Wuhy0411/-/README.md

# 🐁 小鼠滚轮实验平台 (Mouse Running Wheel System)





## 📌 项目简介

本项目旨在通过整合底层硬件外设与上位机软件，搭建一套完整、稳定的小鼠滚轮行为学实验平台。该平台能够实时监测、记录并可视化小鼠在滚轮上的运动速度和路程。

采集到的高精度时间序列数据（如速度、运动距离以及外部输入的ttl信息），格式规整，可直接导出参与后续分析。

---

## 🛠️ 系统架构与环境依赖

本项目由**硬件数据采集端（下位机）** 与**软件数据处理端（上位机）** 两部分组成。

### 1. 硬件环境 (Hardware)
* **核心控制板：** ArControl开发板
* **传感器：** 旋转编码器
* **机械组件：** 标准小鼠测试滚轮、3D打印固定支架等
* **通信线路：** USB 数据传输线

具体的硬件清单在硬件文件夹里的硬件清单.xlsx文件里，根据对应的数量和链接购买拼装即可。

### 2. 软件环境 (Software)
详细的环境安装与配置步骤，请参阅 [《软件开发环境安装指南》](软件/软件安装流程.md)。
* **下位机开发环境：** Arduino IDE
* **上位机开发环境：** VS Code
* **上位机语言与依赖：**
  * Python 3.14 及以上版本
  * `pyserial`：用于与 Arduino 进行串口数据通信
  * `matplotlib`：用于运动数据的实时动态可视化

---

## 🚀 快速开始 (操作说明)

### 第一步：硬件连接
按照硬件拼接教程组装好跑台，具体操作步骤请参阅[《硬件安装步骤说明》](硬件/硬件拼装流程.md)。

### 第二步：下位机程序烧录 (Arduino端)
1. 将Arduino与电脑连接

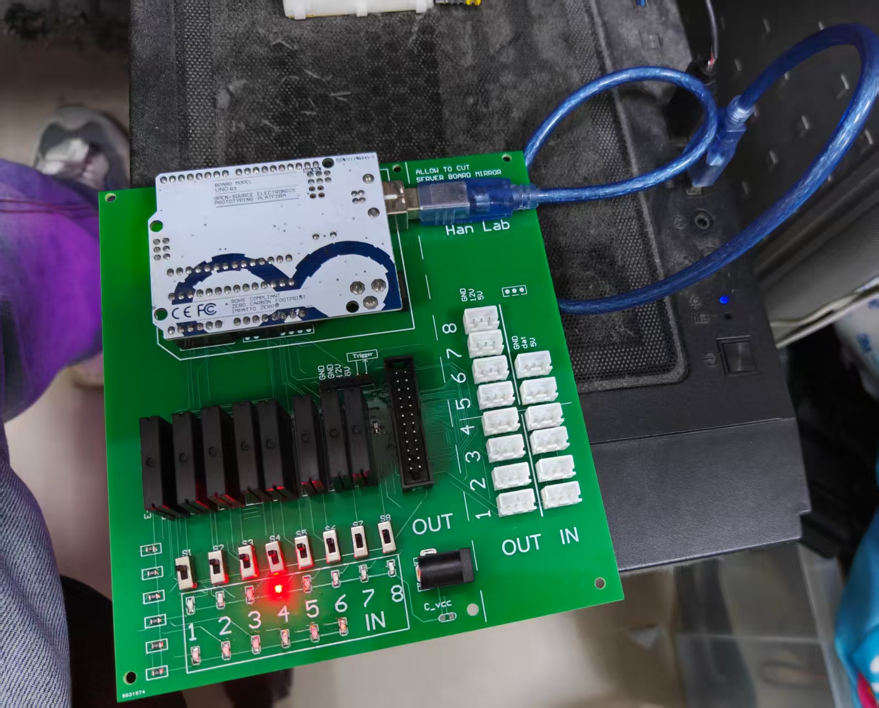
[picture p1: images/1.jpg]
   

2. 打开 `Arduino IDE`。

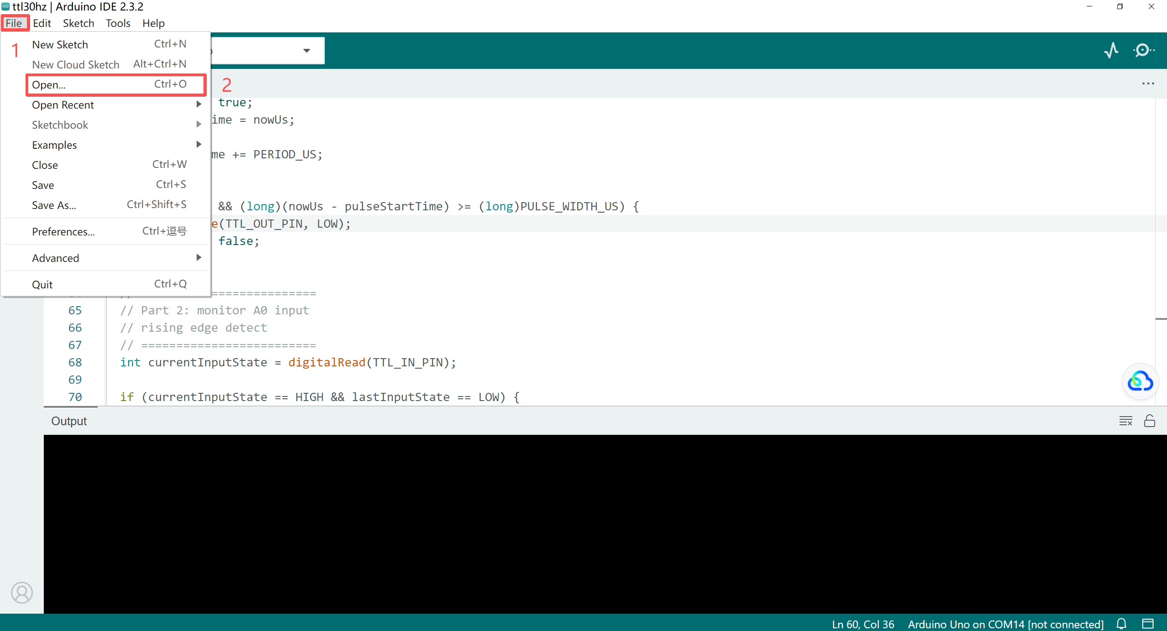
[picture p2: images/2.png]
   

3. 导入本项目 `软件/代码` 目录下的 `TTL monitoring.ino` 源码文件。

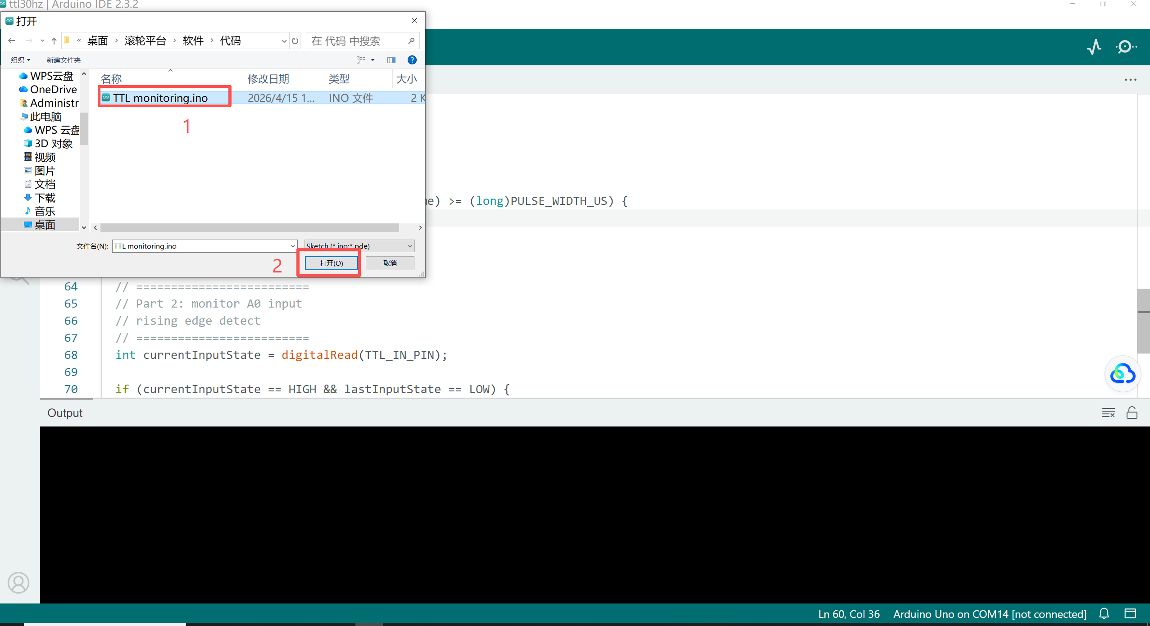
[picture p3: images/3.png]
   

4. 在菜单栏选择对应的开发板型号（arduino uno）及正确识别的 COM 端口（如这里的COM15）。

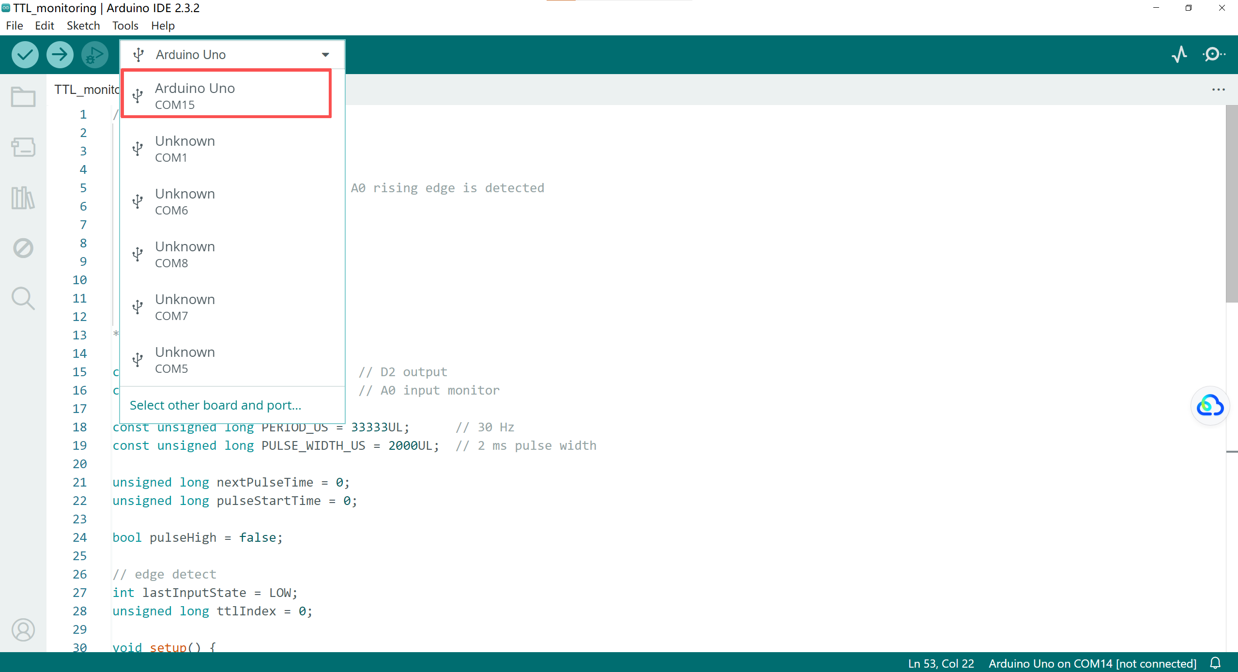
[picture p4: images/4.png]
   

5. 依次点击 **编译**  、**上传 (Upload)** 按钮，将代码烧录至控制板。

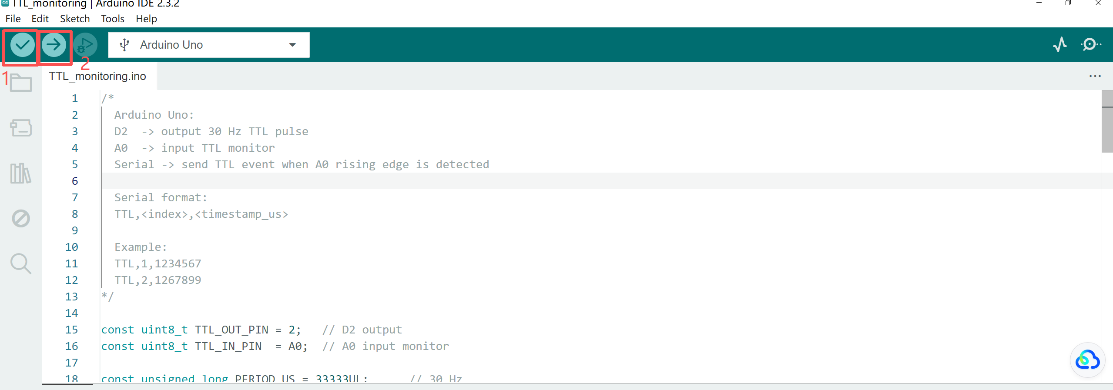
[picture p5: images/5.png]
   

6. 观察到板子上的1口有红灯快速的闪烁即代表烧录成功

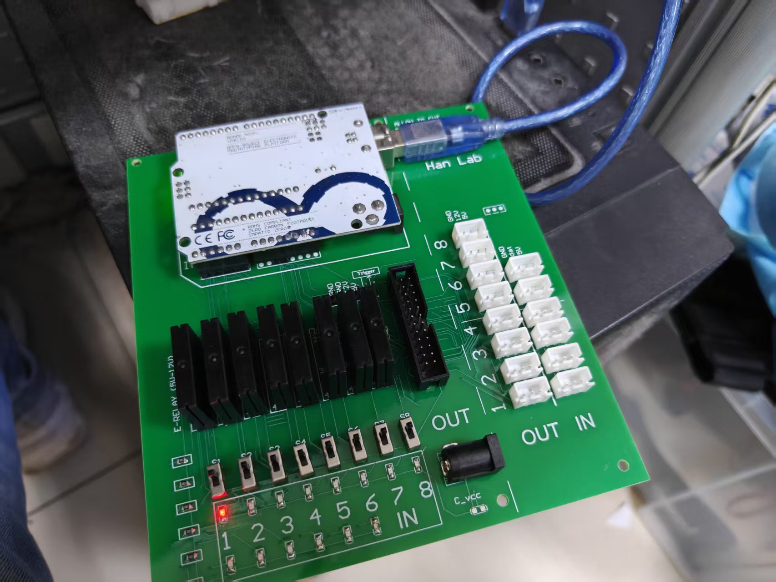
[picture p6: images/6.jpg]
   

### 第三步：上位机数据采集与可视化 (Python端)
1. 右键`软件/代码` 目录下的 `GUI.py` 源码文件，点击打开方式，选择用VS Code打开。

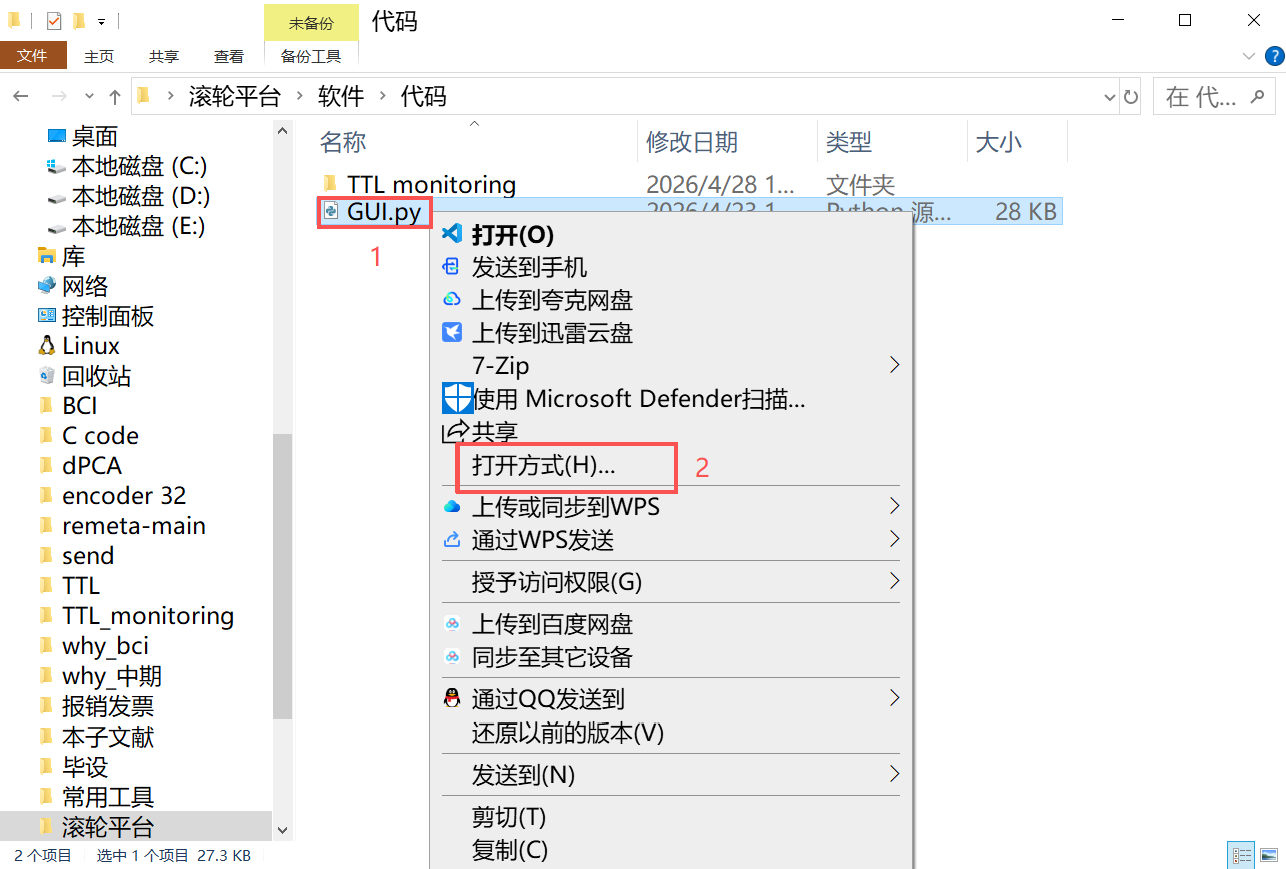
[picture p7: images/7.png]
   

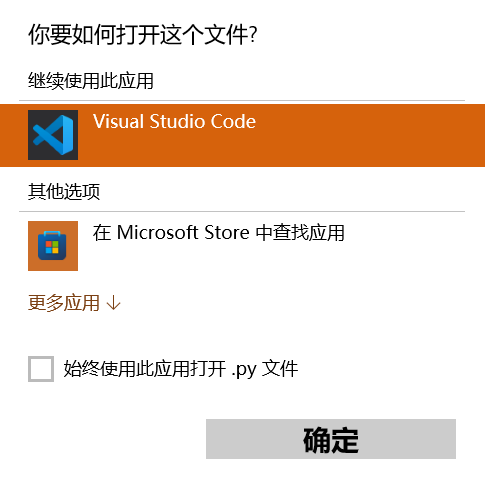
[picture p8: images/8.png]
   

2. 连接好旋转编码器

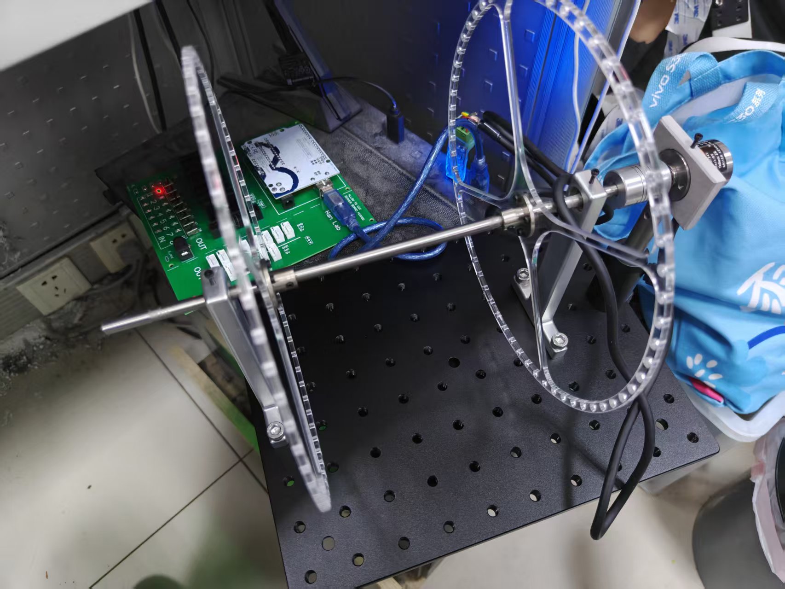
[picture p9: images/9.jpg]
   

3. 检查串口号配置：打开设备管理器，查看端口的下拉菜单，查询到Arduino板子和编码器的端口号分别为`COM15` 和`COM13`，记住这两个端口号。

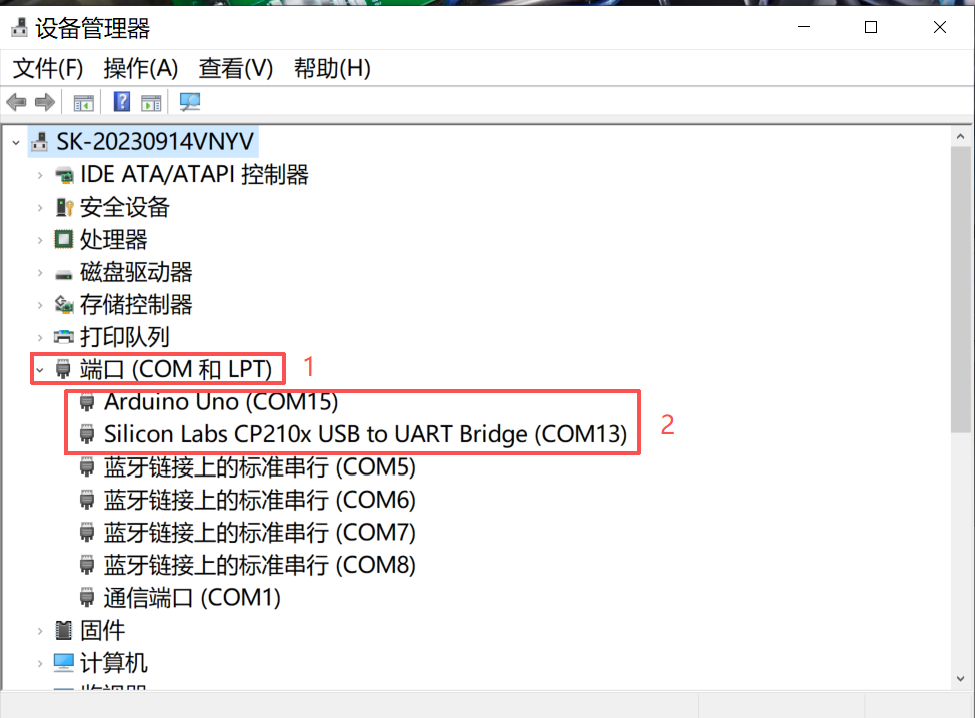
[picture p10: images/10.png]
   

4. 找到GUI主程序的对应位置进行修改。

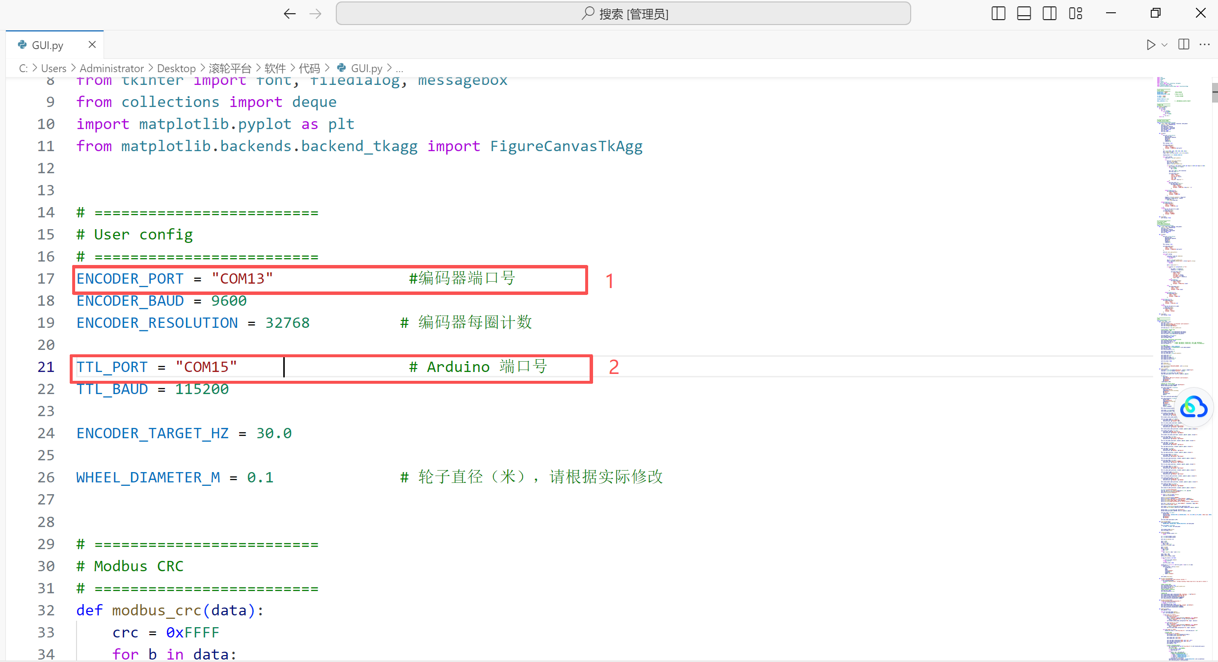
[picture p11: images/11.png]
   

5. 运行主程序开始实验。

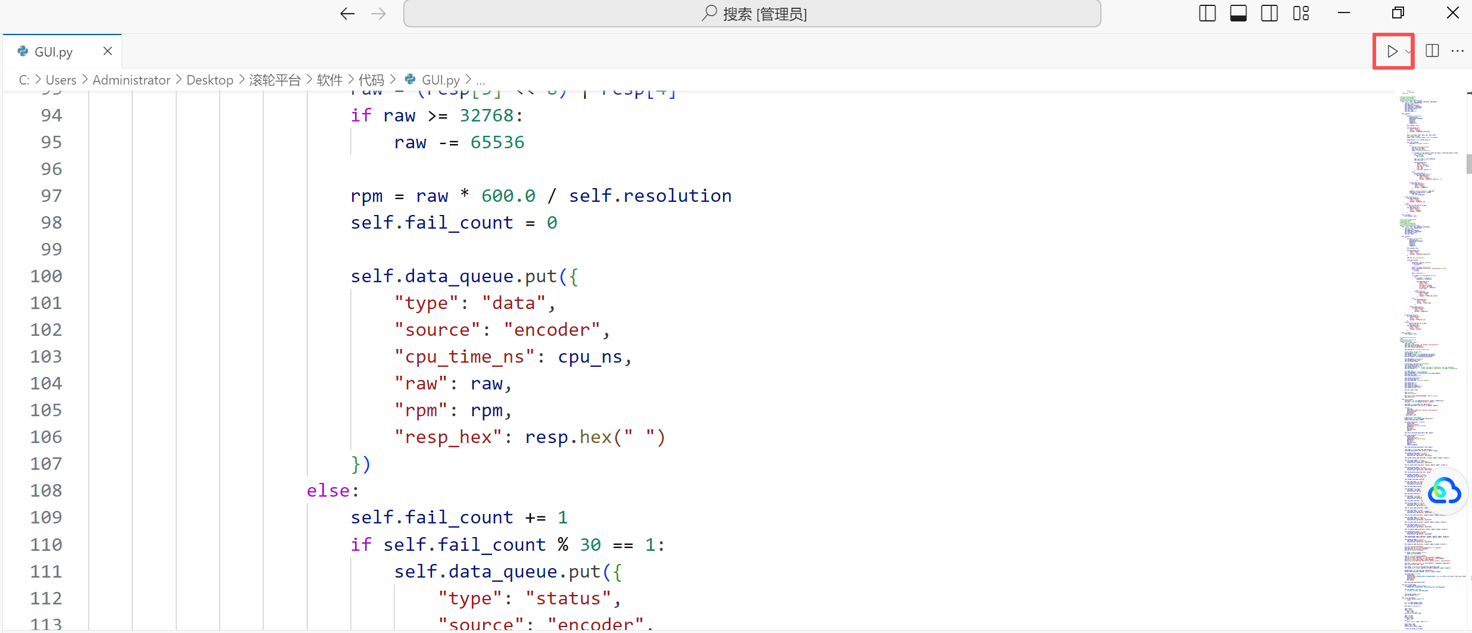
[picture p12: images/12.png]
   

6. **运行现象：**

   * 终端将实时打印旋转编码器的转速和ttl信号数据。

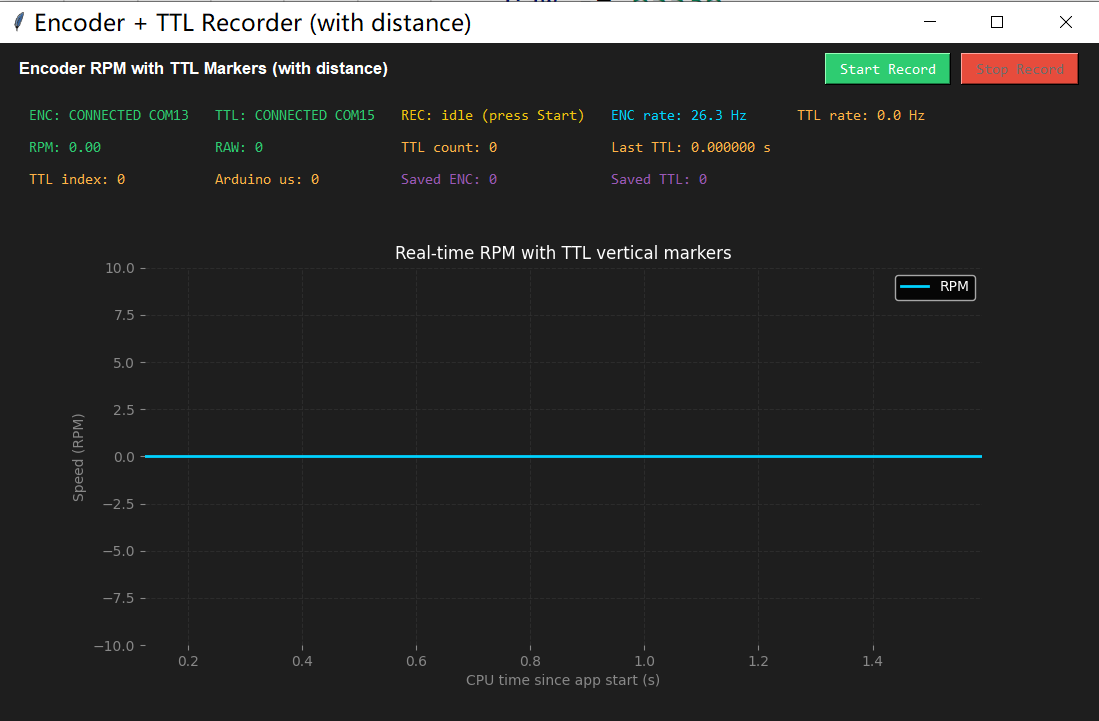
[picture p13: images/13.png]
     

   * 点击start record按钮开始记录转速信息，点击end record结束记录。

   * 点击右上角关闭按钮，弹出保存的csv文件，点击`是` ，找到合适位置点击保存。

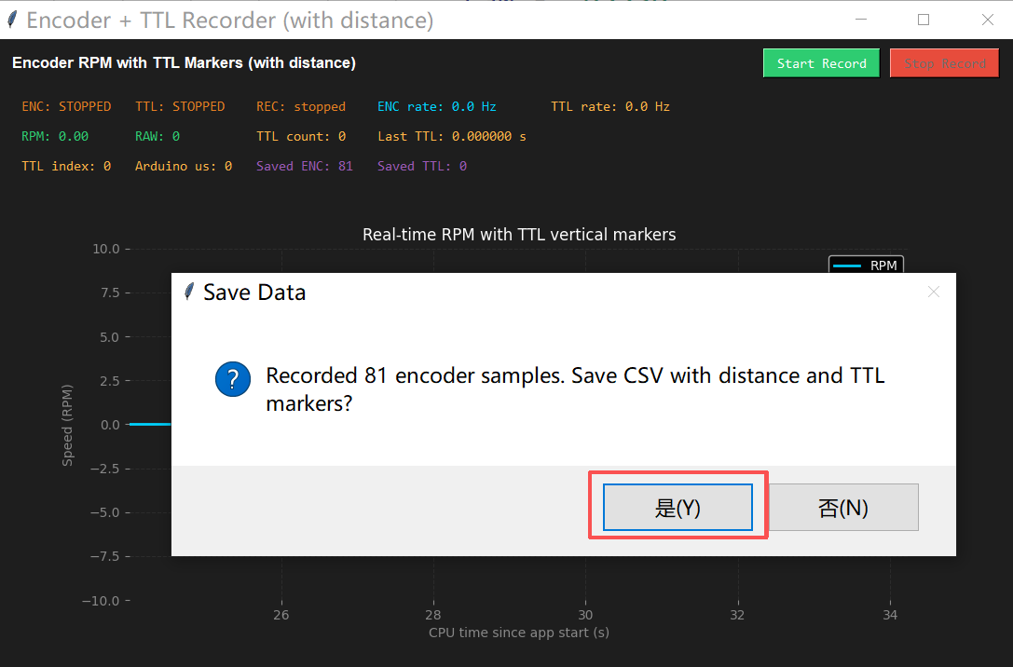
[picture p14: images/14.png]
     

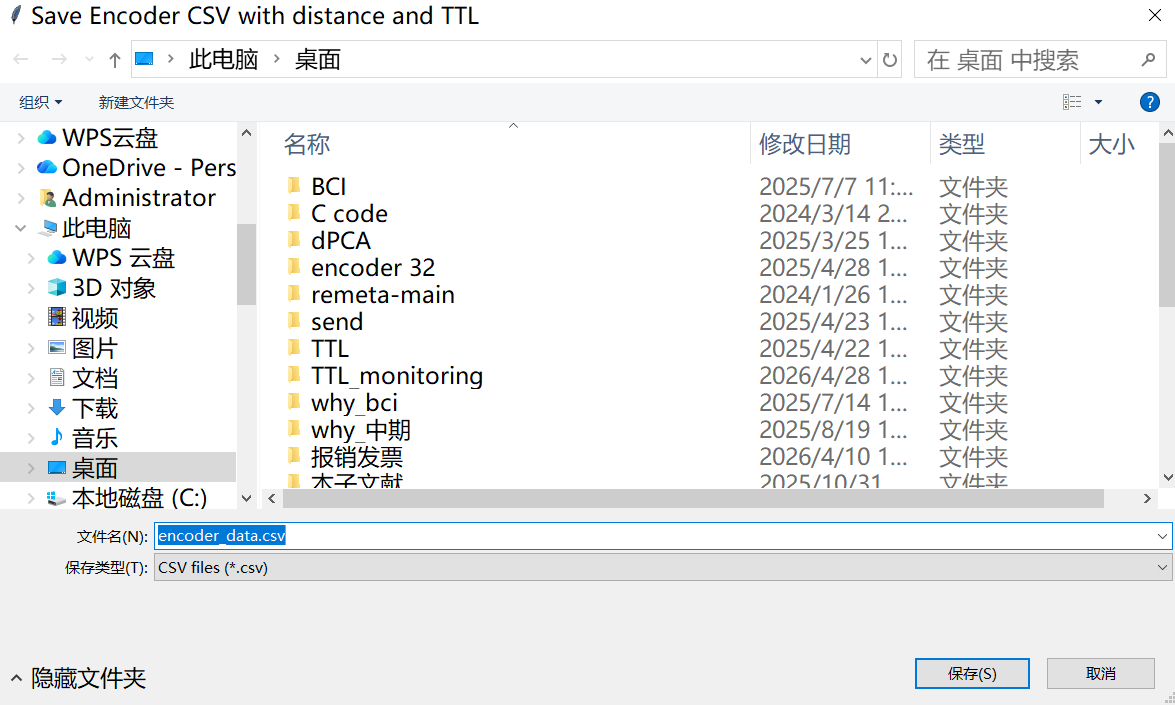
[picture p15: images/15.png]
     

---

## 📁 数据输出说明

实验结束后，关闭GUI界面，会弹出一个保存csv文件的界面，选择对应的文件夹点击保存即可。

**数据包含以下核心字段：**

* `record_rel_s`: 相对记录时间（从点击“Start Record”到该编码器样本的时间间隔，单位秒）
* `cpu_time_ns`: 绝对 CPU 时间戳（纳秒，用于精确对齐）
* `raw`: 编码器原始读数（16位有符号整数，范围 -32768 ~ 32767，对应每圈 32768 个计数）
* `rpm`: 瞬时转速（转/分钟，计算公式：`raw × 600.0 / 32768`）
* `distance_m`: 累计路程（米，根据 `raw` 变化量乘以轮子周长累加得到）
* `ttl_event`: TTL 事件标记（布尔值 0 或 1，1 表示该编码器样本在时间上最接近某个 TTL 脉冲）
* `ttl_index`: TTL 脉冲序号（当 `ttl_event = 1` 时记录对应的序号，来自 Arduino 串口；否则为空）

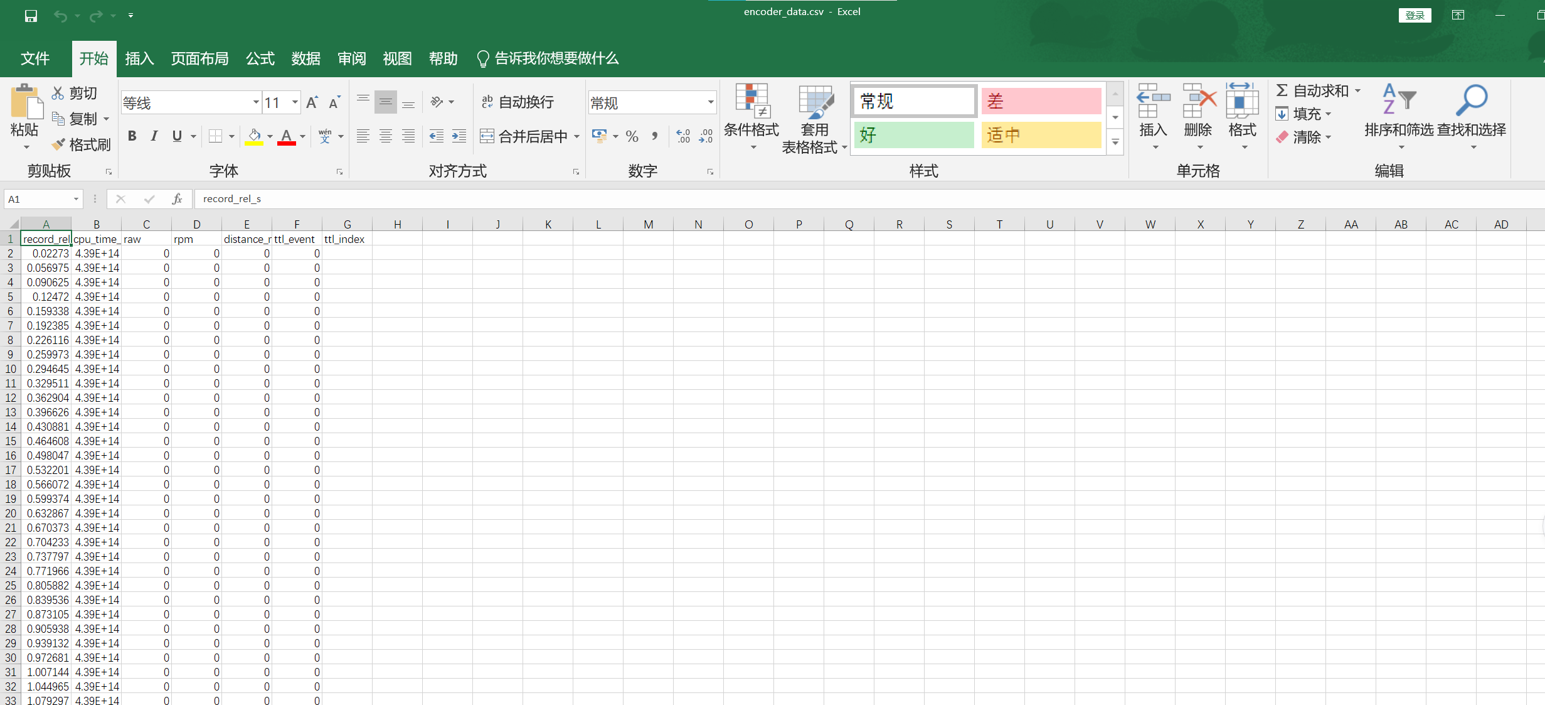
[picture p16: images/16.png]


---

## 🤝 贡献与维护
如有硬件连接问题或软件 Bug，请在项目中提交 Issue 或联系平台维护人员。
