Wuhy0411/-/硬件/3D打印/3D打印流程.md

# 🖨️ 编码器固定器 3D 打印流程指南

本文档将指导您在“未来工厂”平台完成编码器固定器的 3D 打印下单流程，涵盖模型上传、材料选择、特殊工艺（攻牙）配置及最终的订单提交。

---

## 📦 下单操作步骤

### 1. 登录平台与上传模型
1. 在浏览器中打开 **未来工厂** 官方下单网站：<https://www.wenext.cn/manufacture/>
2. 点击页面区域内的 **上传文件**，在弹出的窗口中找到并选择您的模型文件（ `编码器固定器.STL`），等待系统上传并解析完成。
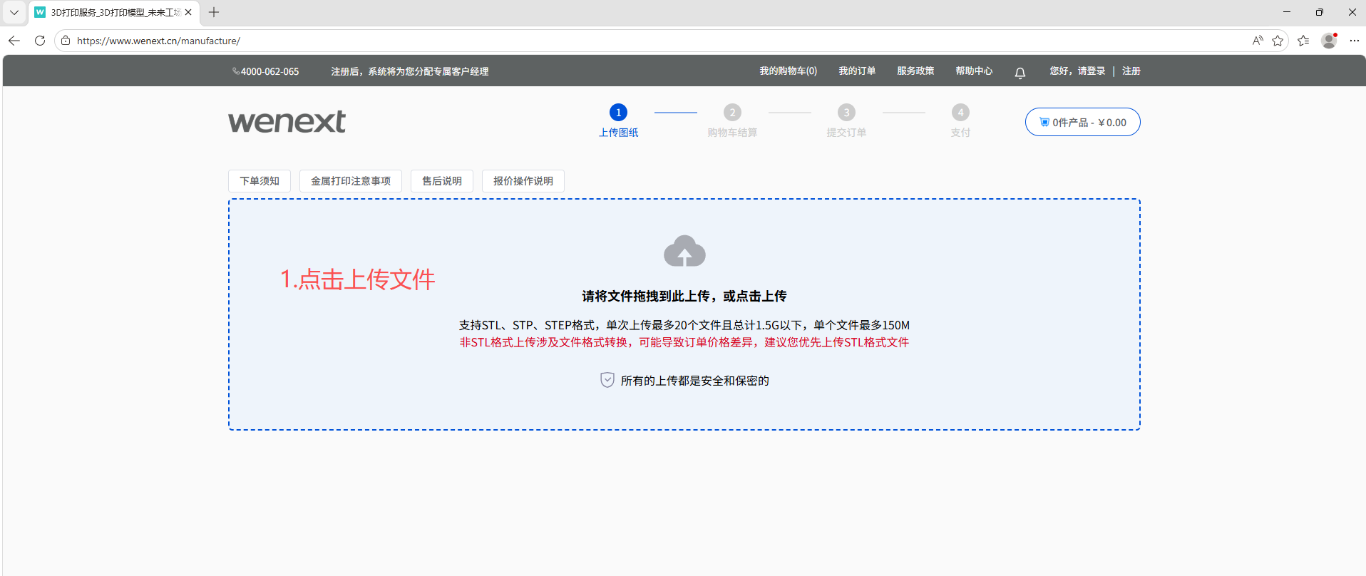
[picture p60: 硬件/3D打印/images/图片1.png]
   
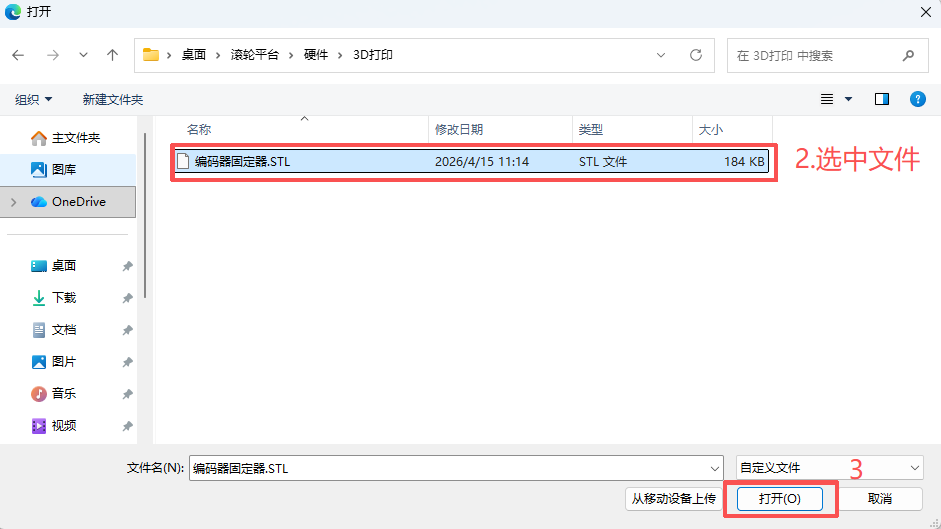
[picture p61: 硬件/3D打印/images/图片2.png]
   

### 2. 选择打印材料
1. 模型解析完毕后，进入参数配置界面。
2. 在材料列表中找到金属类别，将打印材料指定为 **铝合金 6061**。
   > 💡 **提示**：铝合金 6061 具备良好的强度和加工性，非常适合作为滚轮平台硬件的固定连接件。
   
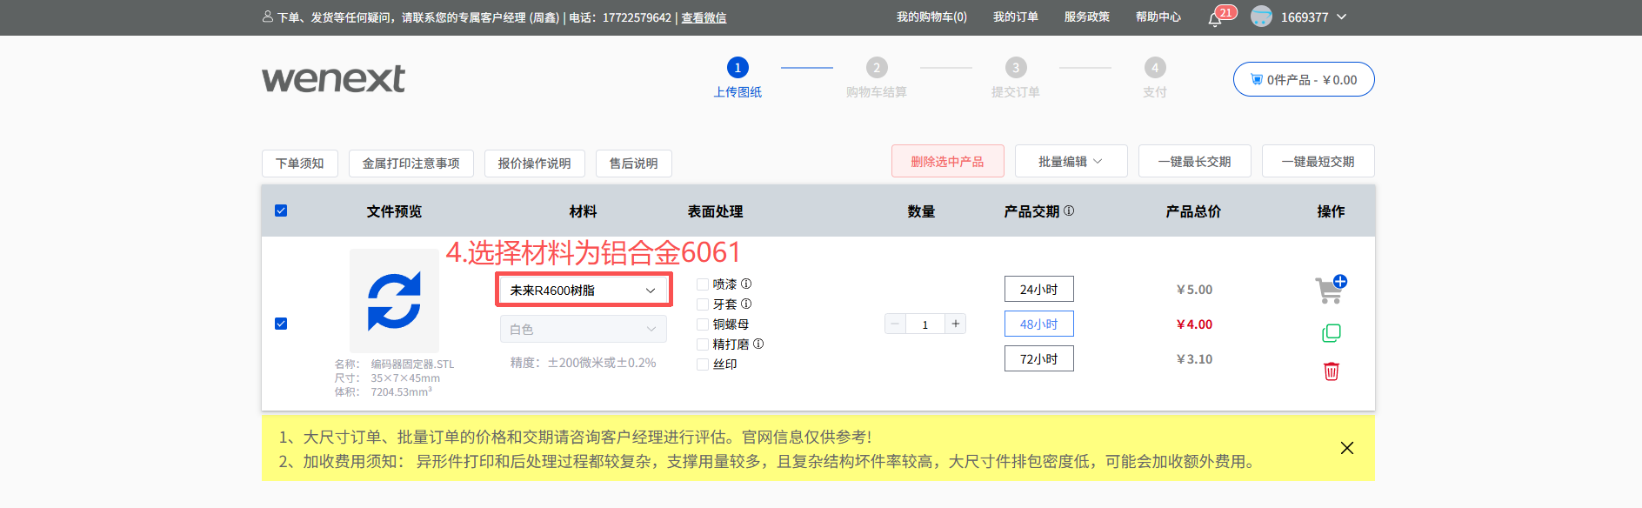
[picture p62: 硬件/3D打印/images/图片3.png]
   
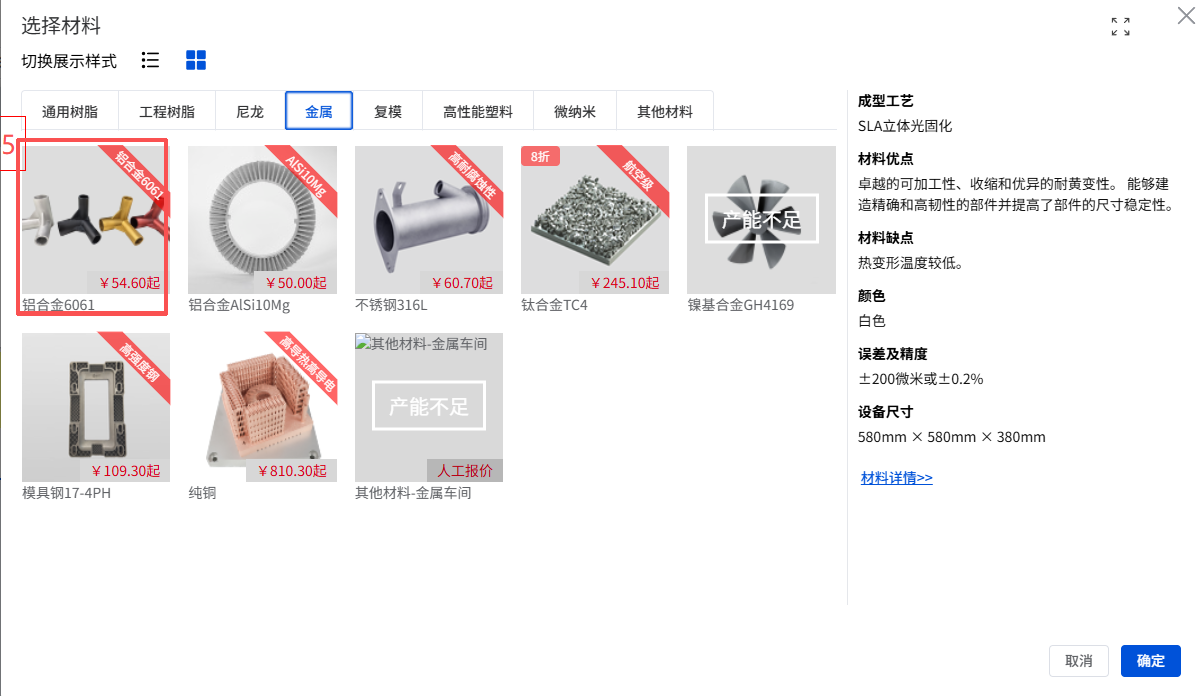
[picture p63: 硬件/3D打印/images/图片4.png]
   

### 3. 配置加工参数（数量与攻牙）
1. 确认该部件的打印 **数量** 设置为 **1**。
2. 在附加服务或表面处理区域，找到并勾选 **攻牙** 服务。
3. 根据项目设计需求，在弹出的规格表中准确填写攻牙类型，包含 **M2** 和 **M4** 规格。
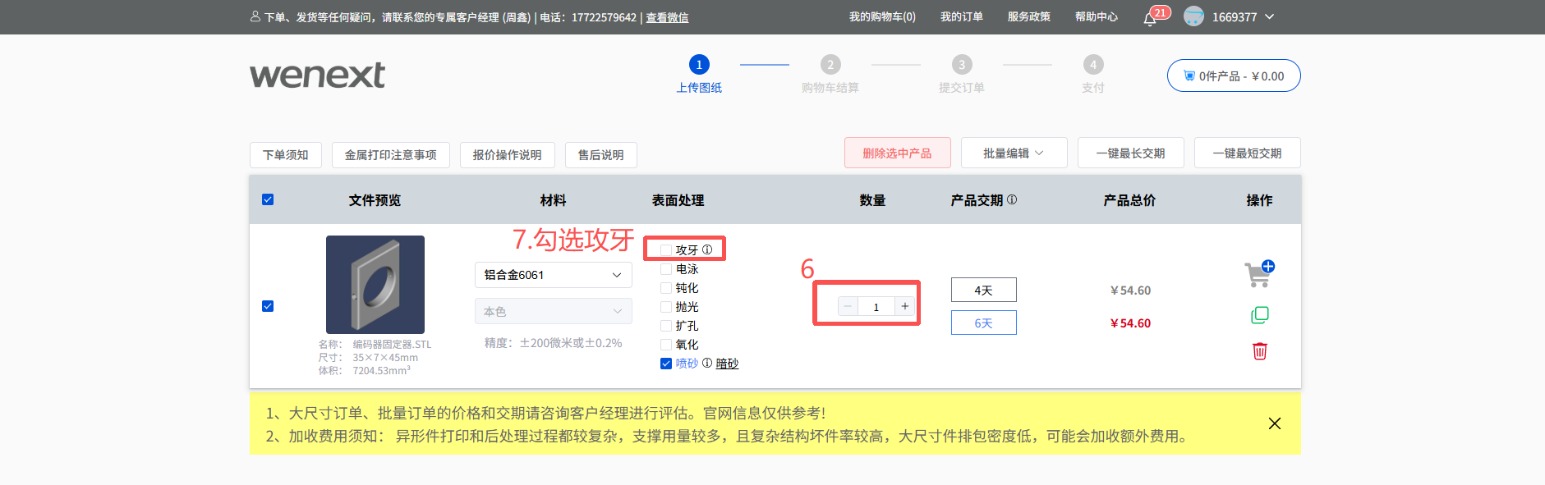
[picture p64: 硬件/3D打印/images/图片5.png]
   
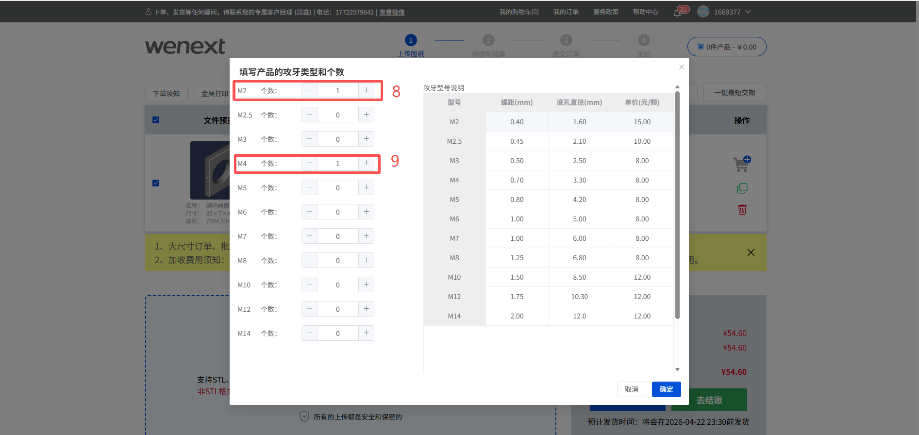
[picture p65: 硬件/3D打印/images/图片6.png]
   

### 4. 结算进入订单页
1. 确认模型预览、材料、数量和攻牙服务均配置无误后，点击页面右下角的 **去结账** 按钮，进入订单结算页面。
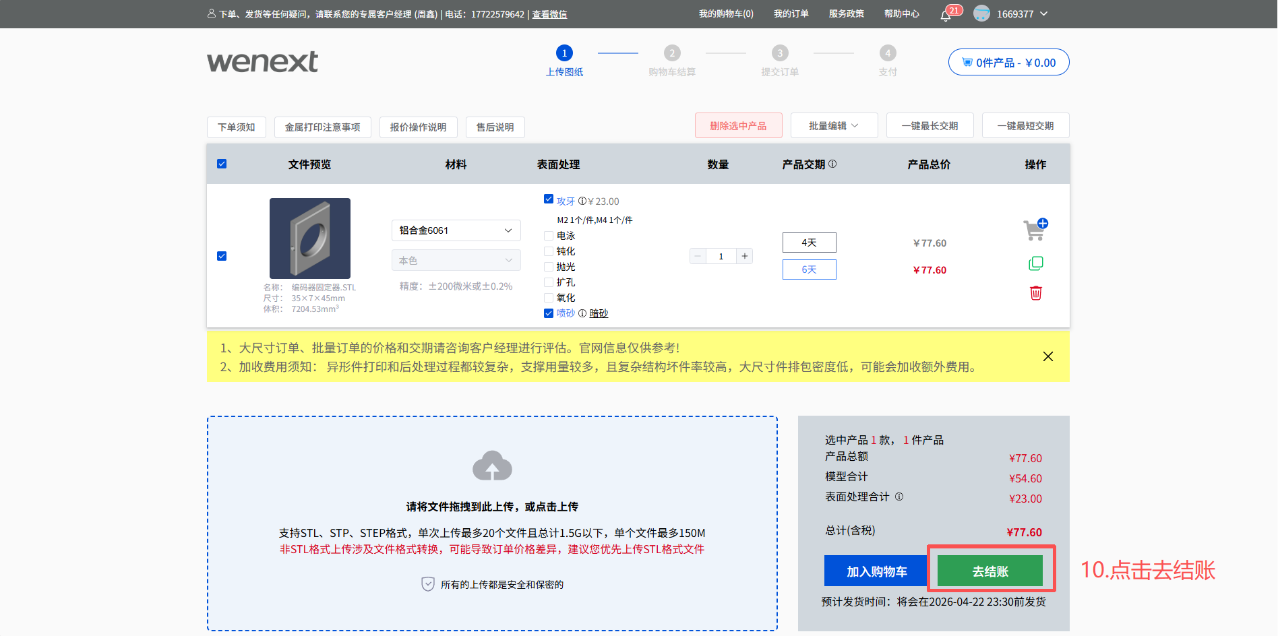
[picture p66: 硬件/3D打印/images/图片7.png]
   

### 5. 填写收货信息与上传附件
1. 在订单确认页面，仔细填写或核对您的 **收货人信息**（姓名、联系方式、收货地址）。
2. **非常重要**：在页面下方找到“处理附件”或“上传攻牙附件”的选项，点击并上传对应的加工说明文档（ `3D打印附件.docx`）。
   
   > ⚠️ **注意**：攻牙附件图纸是工厂确认螺纹孔具体位置的唯一凭证，遗漏上传可能会导致加工错误或订单被驳回。
   
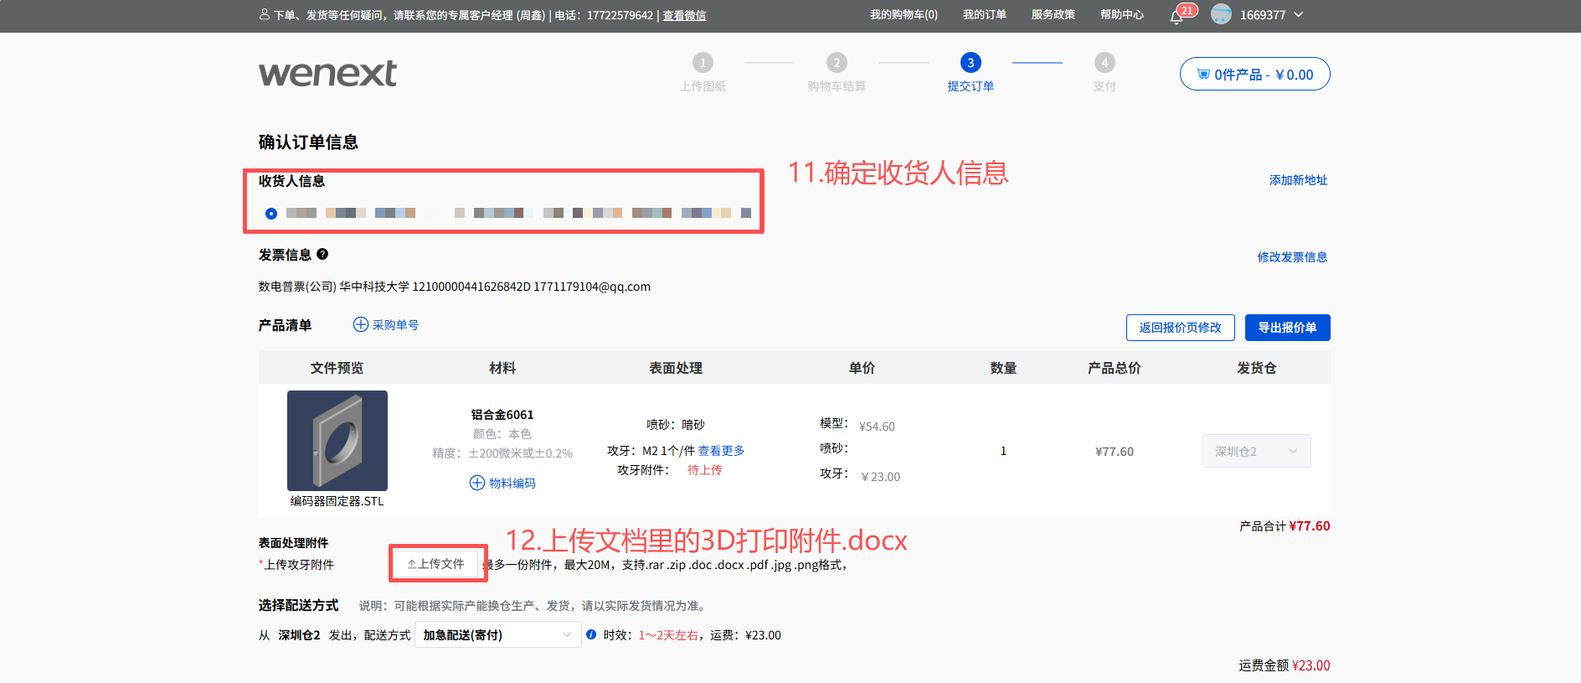
[picture p67: 硬件/3D打印/images/图片8.png]
   
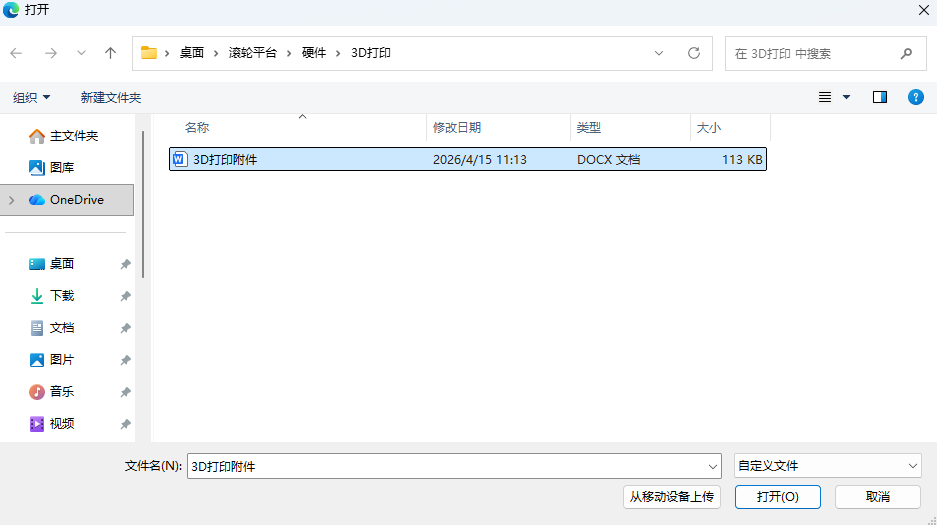
[picture p68: 硬件/3D打印/images/图片9.png]
   

### 6. 提交订单
最后核对产品的总价、交期以及发票等信息，确认无误后点击 **提交订单**，随后根据页面提示完成支付即可安排生产。
