Wuhy0411/-/硬件/3D打印/3D打印附件.docx

攻牙位置：长边顶部和底部中心

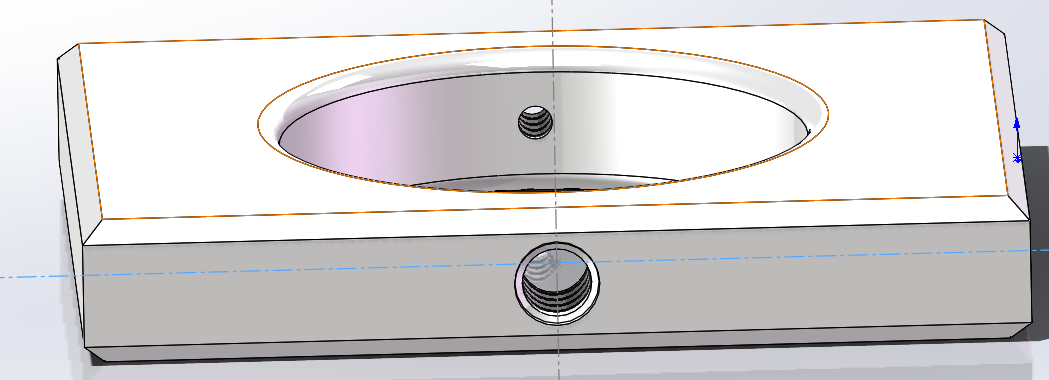
[picture p69: figure]
