Wuhy0411/-/硬件/硬件清单.xlsx

名称 | 型号 | 数量 | 备注 | 链接
空心轴 | 5.8*0.2 | 1 | 1m的空心管，备注切割成25cm的四根管 | https://detail.tmall.com/item.htm?from=cart&id=745981637321&skuId=5315049174096&upStreamPrice=340
旋转编码器 | R485-4mm轴-Φ25-14bit（16384） | 1 |  | https://item.taobao.com/item.htm?from=cart&id=695996843267&sku_properties=-1%3A-1&upStreamPrice=28800
RS485/CAN USB转接模块 | RS485转接模块 | 1 |  | https://item.taobao.com/item.htm?from=cart&id=694517330848&upStreamPrice=3800
法兰联轴器 | 6mm 中间孔直径 | 2 |  | https://item.taobao.com/item.htm?from=cart&id=634656580492&upStreamPrice=500
铝合金弹性绕线联轴器 | 内孔 4*6 | 1 |  | https://detail.tmall.com/item.htm?from=cart&id=528189391720&skuId=4912783788174&upStreamPrice=470
轴承 | MR126ZZ 尺寸6*12*4 | 2 |  | https://detail.tmall.com/item.htm?from=cart&id=747131570809&upStreamPrice=1069
光学接杆支架 | ZGW-12-50T（带底座 高50mm） | 1 |  | https://item.taobao.com/item.htm?from=cart&id=710955731288&upStreamPrice=4500
光学不锈钢支杆 | FUL-12-80 长度80mm | 1 |  | https://item.taobao.com/item.htm?from=cart&id=708532314921&upStreamPrice=1300
铝质面包板M6螺纹孔 | 200*250*10mm | 1 |  | https://item.taobao.com/item.htm?from=cart&id=871738430431&upStreamPrice=23500
M2内六角螺丝钉螺母 | M2*10-50套 | 1 |  | https://detail.tmall.com/item.htm?from=cart&id=631928248397&upStreamPrice=232
M6内六角螺丝钉圆柱头螺钉 | M6*12[20个] | 1 |  | https://detail.tmall.com/item.htm?from=cart&id=635755541429&upStreamPrice=322&skuId=4555949761460
M6全螺纹牙棒牙条 | M6x20 (20个) | 1 |  | https://detail.tmall.com/item.htm?from=cart&id=836839573569&upStreamPrice=215
亚克力板 | 根据零件定制加工 | 2 | 将辐条零件发送给客服，定制加工 | https://item.taobao.com/item.htm?from=cart&id=20358851997&skuId=6145774878326&upStreamPrice=100
支撑杆 | 铝合金CNC加工 | 2 | 将支撑杆零件发送给客服，定制加工 | https://item.taobao.com/item.htm?id=707615151970&xxc=shop&skuId=5559259352419
编码器固定器 | 铝合金6061，3D打印 | 1 | 上传零件和附件，勾选攻牙服务 | https://www.wenext.cn/manufacture/
