Wuhy0411/-/硬件/3D打印/编码器固定器.STL

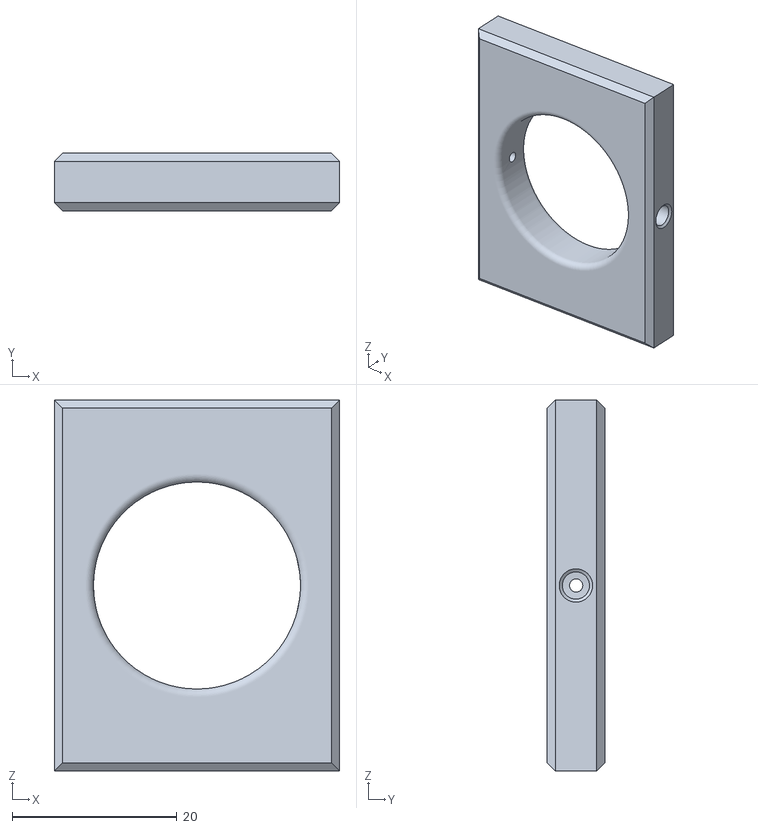
[picture p70: CAD file, 2026-04-15]
硬件/3D打印/编码器固定器.STL
34.6 x 7.00 x 45.0
