Wuhy0411/-/硬件/CNC加工/支撑杆.STEP

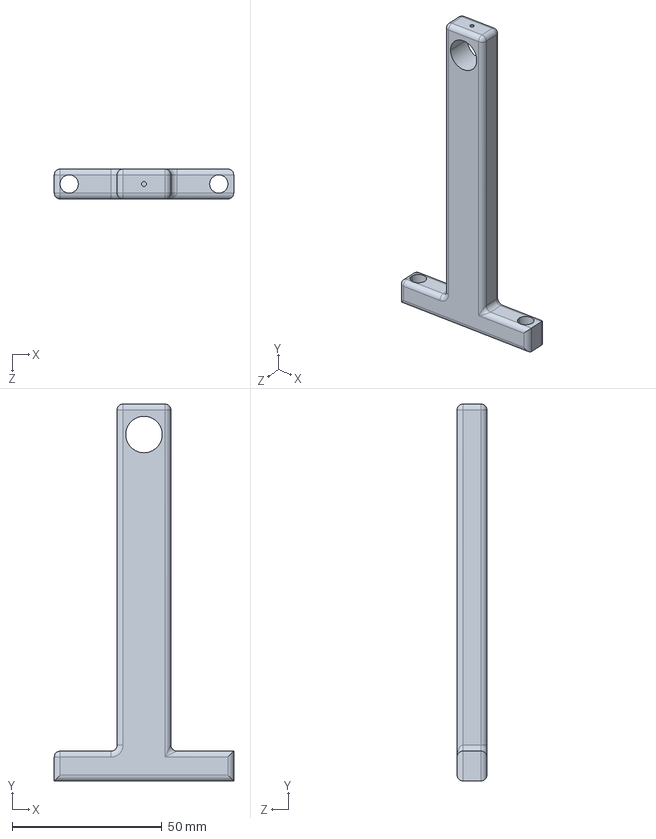
[picture p71: CAD file, 2026-04-15]
硬件/CNC加工/支撑杆.STEP
60.0 x 126.0 x 10.0 mm
