Wuhy0411/-/硬件/激光切割/辐条.STEP

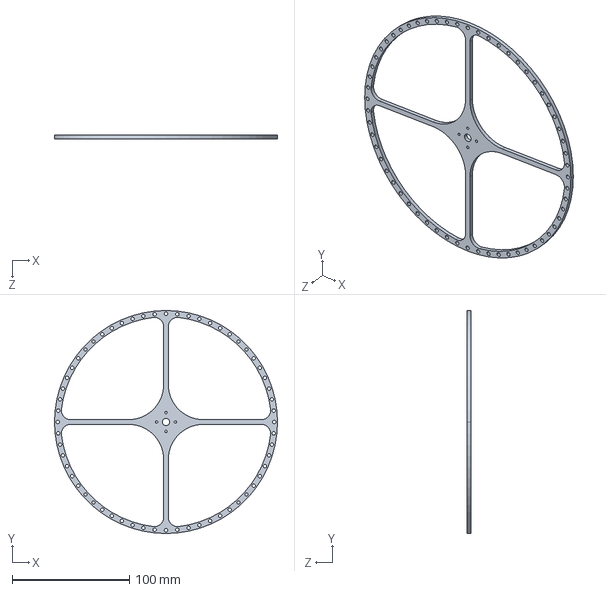
[picture p72: CAD file, 2026-04-23]
硬件/激光切割/辐条.STEP
190.5 x 190.5 x 3.00 mm
