Wuhy0411/-/(notices)

Notices in the files:
README.md:
License: MIT
